RomanAlexandroff/42-Smart-Cluster-Sign/docs/tech_documentation/23-confidential-information.adoc

= Suggestions for Dealing with Confidential Information
:imagesdir: media
ifndef::backend-pdf[]
:toc: auto
:sectnums:
endif::[]

NOTE: This chapter is a stub — see issue #71.
