RomanAlexandroff/42-Smart-Cluster-Sign/(threads)

Thread 1 (2024-08-24):

[ISSUE] The Sign may report incorrect Exams status in Telegram chat

RomanAlexandroff, 2024-08-24:
When prompted with the "/status" command in the Telegram chat, the Sign answers with some information about its work including information about exams. If the Sign is prompted before the first wake-up of the day (currently, it is set to 6 AM) or after the last wake-up of the prior day (currently, it is 9 PM), the device always replies with "no exams today" even if there is an exam.

This happens due to the location of the ft_telegram_check() function, which is responsible for answering in the Telegram chat, in the program. This function is located before the function which checks the exams on the 42 Intra server. In short, the Sign outputs information before checking it.

The issue does not occur if the Sign gets prompted after the first wake-up of the day. The issue cannot be fixed simply by moving the ft_telegram_check() function since the function is also responsible for triggering the OTA functionality. Moving it elsewhere would definitely break the OTA functionality.

Since the "/status" command is not intended for the students, but for the 42 employees, whose working days generally start later than 6 AM, it is highly unlikely that this issue will be encountered by the Sign users. Thus, this issue will not be primarily worked on.

Closed 2024-11-07.

Thread 2 (2024-09-08):

[BUG] Data loss over deep sleep

RomanAlexandroff, 2024-09-08:
Over deep sleep, the device "forgets" the name of the Telegram chat it has been written from. It is strange because the variable containing this data is located in the RTC memory therefore its value should persist over deep sleep. The issue may affect all the RTC-stored variables.

RomanAlexandroff, 2024-11-07:
The bug has been resolved with the latest update. It appears that the cause of the issue was the use of String object variables in RTC memory. Refactoring these RTC memory String variables into C-style string arrays has fixed the problem.

Closed 2024-11-07.

Thread 3 (2024-10-09):

[BUG] Telegram falls-off after full flash erase

RomanAlexandroff, 2024-10-09:
After burning new software with full flash erase the Sign looses its Telegram chat ID and all the Telegram functionality becomes unavailable. It means that the remote Secret token update and all the in-chat notifications are off. Rebooting the device does not help. It is probably connected with this issue: [[BUG] Data loss over deep sleep #2](https://github.com/RomanAlexandroff/42-Prague-Smart-Sign/issues/2#issue-2512462232)

RomanAlexandroff, 2024-11-08:
After testing with software version 4.23, the bug could not be replicated. I am marking this issue as resolved. Please, feel free to reopen it if the bug occurs again.

Closed 2024-11-08.

Thread 4 (2024-11-08):

[BUG] Serial port drops off

RomanAlexandroff, 2024-11-08:
The Serial port behaves strangely at the start of the program execution. Immediately after booting up, a few lines of output from the device appear in the Serial monitor, followed by a pause of about 1 second with no new messages. After this pause, the device resumes sending messages as intended. However, I have to restart the Serial monitor to see them. I'm not sure if the device is restarting the Serial port or rebooting completely during that 1-second pause. This bug has no affect on the user experience, but makes debugging slightly more complicated than it has to be.

RomanAlexandroff, 2024-11-09:
The behaviour of the Serial port was caused by the initialisation of the display SPI port. Now that the SPI port initialises first, it no longer interrupts the Serial port.

Closed 2024-11-09.

Thread 5 (2025-01-10):

[BUG] Exam information note fails to display the time

RomanAlexandroff, 2025-01-10:
SW version 4.29. The Sign stopped displaying the exam time in the exam notification notes. The first photo shows the way it used to work and the second photo shows the current state. My assumption is that the watchdog disrupts the execution of the function responsible for drawing the exam time. Unfortunately, as of now, I cannot check it.

{CORRECT OPERATION}
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

{CURRENT BEHAVIOUR}
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

RomanAlexandroff, 2025-01-16:
The issue has been fixed in the SW version 4.32. by increasing the time delay between drawing the text and drawing the exact time from 500 milliseconds all the way to 6000 milliseconds.

Presumably, the issue was caused by introducing a watchdog to the program in the first place. Since the drawing process takes a very long time, the watchdog has to be turned off before the drawing process starts and turned on again after the drawing process is finished. Since drawing the text and drawing the exact time are two separate drawing processes, the watchdog turns on and off again in a very short sequence between them. I assume that the extra time is needed for the underlaying firmware to process the watchdog switching. This solution is sub-optimal and will require further examination.

Closed 2025-01-16.

Thread 7 (2025-03-01):

[BUG] Visual artifacts instead of OTA Update message

RomanAlexandroff, 2025-03-01:
When the Sign attempts to display the service message regarding the Over The Air (OTA) update port being active, it fails to present the message correctly. Instead of the intended notification, the Sign shows visual artifacts that disrupt the user experience.

**Steps to reproduce:**

1. Trigger the OTA update port to open - by pressing the OTA button on the device OR by sending the OTA command in the Telegram chat and waking the Sign up.
2. Observe the display.

**Expected Behaviour:**

- The Sign shall display the cluster number and clearly show a message indicating that the OTA update port is active next to the number.
- After the OTA update port is closed, the Sign shall replace the OTA update port message with the normal state pictograms or another appropriate note.

**Actual Behaviour:**

- The Sign updates a very small part of the display.
- Visual artifacts appear instead of the proper service message.
- After the OTA update port is closed, only the small part of the display refreshes leaving wide red stripe across the screen.

_the behaviour while the OTA port is active_

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

RomanAlexandroff, 2025-03-02:
Solved.
- The text window was very small that is why the display was updating only that small rectangle. That was also the reason why we can see only a fragment of a letter "E" from the word "UPDATE".
- The text window coordinates were also off, that is why the rectangle was in the middle of the display.
- The display did not return to its normal state when the OTA update port was closed because the display did not have enough time to process the second refresh, so it skipped it. Implementing a delay fixed this issue.

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

Closed 2025-03-02.
