RomanAlexandroff/42-Smart-Cluster-Sign/src/cluster_number_mode.cpp

/* ************************************************************************** */
/*                                                                            */
/*                                                        :::      ::::::::   */
/*   cluster_number_mode.cpp                            :+:      :+:    :+:   */
/*                                                    +:+ +:+         +:+     */
/*   By: raleksan <r.aleksandroff@gmail.com>        +#+  +:+       +#+        */
/*                                                +#+#+#+#+#+   +#+           */
/*   Created: 2024/04/09 13:00:00 by raleksan          #+#    #+#             */
/*   Updated: 2026/07/25 13:20:00 by raleksan         ###   ########.fr       */
/*                                                                            */
/* ************************************************************************** */

#include "42-Smart-Cluster-Sign.h"


static bool handle_secret_expiration(void)
{
    int16_t  days_left;
    
    watchdog_reset();
    days_left = expiration_counter();
    if (days_left <= 3 && days_left != FAILED_TO_COUNT)
    {
        draw_on_display(SECRET_EXPIRED);
        DEBUG_PRINTF("\n[INTRA] IT IS TIME TO UPDATE THE SECRET!\n");
        send_telegram_message(compose_message(SECRET_EXPIRED, days_left));
        return (true);
    }
    return (false);
}


/*
*   Makes sure to get exams info or display an error
*   and notify the User. The function intentionally
*   ignores turning WiFi module off in case of Intra
*   Error because in this situation the device goes
*   directly into sleep anyway.
*/
static bool ensure_exams(unsigned int* p_sleep_length)
{
    uint8_t retries;
    ERROR_t intra_status = UNKNOWN;
    
    retries = 0;
    while (intra_status != INTRA_OK && retries < RETRIES_LIMIT)
    {
        ft_delay(retries * 300000);
        DEBUG_PRINTF("\n[INTRA] Fetching exams data — try #%d\n\n", retries + 1);
        intra_status = fetch_exams();
        retries++;
        if (intra_status != INTRA_OK && retries != RETRIES_LIMIT)
            DEBUG_PRINTF("\n[INTRA] Retrying in %d minute(s)\n", retries * 5);
    }
    if (intra_status != INTRA_OK)
    {
        send_telegram_message(compose_message(intra_status, 0));
        WiFi.mode(WIFI_OFF);
        draw_on_display(INTRA_ERROR);
        DEBUG_PRINTF("\n[INTRA] ERROR OBTAINING EXAMS. Turning off\n");
        rtc_g.exam_status = false;
        *p_sleep_length = time_till_wakeup();
        return (false);
    }
    /* it's OK to turn WiFi off here since OTA executes only in
    3% of all runs and handle_secret_expiration - once a year */
    WiFi.mode(WIFI_OFF); 
    return (true);
}


/*
*   This is the function that orchestrates everything happening
*   in this file. Here is its high-level logic in simple steps:
*   1. make sure there is a Wi-Fi connection,
*   2. pull exams information from Intra, 
*   3. if pulling failed, go to sleep till next scheduled hour,
*   4. if exam is in less than 1 hour, go streight to exam mode,
*   5. if exam is in more than 1 hour, display exam info note,
*           set sleep time till 1 hour before the exam begins,
*   6. if no exam, set sleep time till next scheduled hour,
*           check secret expiration, display cluster number. 
*/
void  cluster_number_mode(unsigned int* p_sleep_length)
{
    watchdog_reset();
    if (!ensure_exams(p_sleep_length))
        return;
    if (rtc_g.exam_status)
    {
        if (com_g.hour >= (rtc_g.exam_start_hour - 1) && com_g.hour <= com_g.exam_end_hour)
            *p_sleep_length = REBOOT;
        else
        {
            draw_on_display(EXAM_DAY);
            *p_sleep_length = time_till_event(rtc_g.exam_start_hour - 1, rtc_g.exam_start_minutes);
        }
        return;
    }
    *p_sleep_length = time_till_wakeup();
    if (handle_secret_expiration())
        return;
    draw_on_display(CLUSTER_DEFAULT);
}
 
