RomanAlexandroff/42-Smart-Cluster-Sign/(commit log)

2025-03-02 fix OTA display artifacts (Issue #7)
    [display_handling.cpp]
2025-03-03 add error handling debugging message to the watchdog reset
    [watchdog.cpp]
2025-03-03 fix the device not rebooting after successful OTA update
2025-03-03 add impicitly setting the OTA flag to false to prevent spontaneous OTA port activations after exams
    [exam_mode.cpp]
2025-03-03 fix OTA spontaneous activation after exams (Issue #6)
    [buttons_handling.cpp, exam_mode.cpp, globals.cpp, globals.h, other.cpp, telegram_bot.cpp]
2025-03-18 fix exam time drawing bug
    [display_handling.cpp]
2025-03-20 fix summer/winter time change bug
    [intra_interaction.cpp, time_utilities.cpp]
2025-03-20 fix bug in counting remaining days until Secret token expiration
    [time_utilities.cpp]
2025-03-22 fix GitHub Actions CI cleaning stage
2025-04-01 fix system time winter/summer change bug
    [config.h, time_utilities.cpp]
2025-04-05 fix summer time shift
    [intra_interaction.cpp]
2025-04-05 add error handling for ft_delay()
    [other.cpp]
2025-05-13 rename file and add print time compensation in ft_delay()
2025-05-13 add print time compensation in ft_delay()
2025-05-23 add device name into Telegram response
2025-06-25 add unused pins termination to the ground
2025-08-14 fix file system initialization retries
    [config.h, file_system.cpp]
2025-08-21 add function prototype for code clarity
2025-09-26 fix summer/winter time change issue
    [config.h, globals.cpp, globals.h, intra_interaction.cpp, time_utilities.cpp]
2025-10-14 remove redundant issue message
    [telegram_compose_message.cpp]
2026-04-21 fix faulty debug output of acquired unix timestamp
    [intra_interaction.cpp]
2026-07-02 fix logic bug in time_till_event() causing value underflow
    [time_utilities.cpp]
2026-07-02 Update OTA firmware version and URL for device
    Testing OTA update Rollback
2026-07-14 fix comminication with Intra server
    [42-Smart-Cluster-Sign.h, file_system.cpp, intra_interaction.cpp, time_utilities.cpp]
2026-07-14 fix a typo in the code
    [config.h, ota.cpp]
2026-07-18 add WiFi module shut down when no longer needed
    [cluster_number_mode.cpp]
2026-07-25 minor improvements and fixes
    [42-Smart-Cluster-Sign.h, battery_management.cpp, cluster_number_mode.cpp, config.h, exam_mode.cpp, intra_interaction.cpp, ota.cpp, ota_rollback.cpp]
2026-07-27 fix new Secret getting accepted even if Intra fails
    [file_system.cpp]
2026-07-27 minor code style fixes
    [cluster_number_mode.cpp, ota_rollback.cpp]
2026-07-27 fix arduino-cli config
2026-08-07 implement fix for the Issue #52
    [config.h, utils.cpp]
2026-08-11 fix printing the percent character in a debug message
    [battery_management.cpp]
2026-08-18 Update manifest.json
    Updated the firmware version for the 42PRAGUEAPI SCREEN device from 4.39 to 4.99 to force the device to accept the same version update with a tiny change
2026-08-22 update the logic and fix debugging messages
    [display_handling.cpp]
2026-08-23 fix endless blocking wait in time_sync if device woken up in Exam mode
    [config.h, constants.h, exam_mode.cpp, time_utilities.cpp, utils.cpp]
2026-08-25 Refactor README for clarity and consistency
    Updated section headings and links for clarity and consistency. Added a detailed description for the Bill of Materials and improved the formatting of the Contributing section.
